thisnameissoclever/parametric-multibin/shells/multibin-shell/MultiBin Shell - Parametric.scad

// MultiBin Shell - parametric remake
// Rebuilds MultiBuild's MultiBin shells (Standard Base) from measurements, so
// matching sizes reproduce the published shells. Other sizes follow the same
// rules, with a rule of this generator's own for a width or front-to-back size
// that ends in a half LU. Paste this whole file into MakerWorld's Parametric
// Model Maker.
//
// Print orientation: the base is on the build plate and the opening is on top.
// X = width, Y = front to back on the plate, Z = up. The left and front outer
// faces are at x = -25 and y = -25, so a whole first cell is centred on the
// origin. A drawer made with the same three numbers fits inside with its bottom
// against the front wall: the drawer's height runs along Y and its depth along Z.

/* [Size in LU (1 LU is 50 mm; the same numbers as the drawer that goes inside)] */
// Width in LU (X). A half LU adds a 25 mm cell at the right end, with no central base pocket
width_lu = 2; // [1:0.5:12]
// Drawer height in LU: the shell's front-to-back size on the build plate (Y). A half LU adds a 25 mm cell at the back, with no central base pocket
height_lu = 1; // [0.5:0.5:12]
// Drawer depth in LU, along the shell's height as printed (Z). The shell is 50 mm per LU plus 5 mm tall
depth_lu = 2; // [1:0.5:12]

/* [Walls (front faces the front of the build plate)] */
// Front wall, which the drawer's bottom goes against. Rail channels sit only on whole 50 mm cells, so a side shorter than 1 LU, and the half-LU end of a side, have none
front_wall = "topped"; // [topped, topless, simple]
// Back wall
back_wall = "topped"; // [topped, topless, simple]
// Left wall (every choice builds the same wall on a shell 0.5 LU front to back)
left_wall = "topped"; // [topped, topless, simple]
// Right wall (every choice builds the same wall on a shell 0.5 LU front to back)
right_wall = "topped"; // [topped, topless, simple]

/* [Hidden] */
// any other wall kind would build a wall that matches no original
for (w = [["front_wall", front_wall], ["back_wall", back_wall], ["left_wall", left_wall], ["right_wall", right_wall]])
    assert(w[1] == "topped" || w[1] == "topless" || w[1] == "simple",
           str(w[0], " must be topped, topless or simple, not ", w[1]));

$fs = 0.25;
$fa = 2;
eps = 0.01;
// thickness of the end slabs of a loft. A solid that continues a loft overlaps
// it by exactly one slab, so the overlapping sections are identical: a larger
// overlap leaves a 0.01 mm ledge where the loft is still narrower, which
// OpenSCAD's export can close into a void at some positions.
slab = 0.001;
arc_fn = 32;                     // facets on the small pocket arcs (chord error 0.011 mm)

U  = 50;
// Shells are built from 25 mm and 50 mm cells, and the drawer generator builds
// a drawer at whatever size it is given, so the shell accepts only the sizes
// its sliders offer: half-LU steps within each range. Any other value stops the
// render with an error, rather than building a shell of a different size from
// the drawer made with the same numbers.
max_lu = 12;
function on_slider(v, lo) = is_num(v) && v >= lo - 1e-6 && v <= max_lu + 1e-6
                            && abs(2 * v - round(2 * v)) < 1e-6;
for (v = [["width_lu", width_lu, 1], ["height_lu", height_lu, 0.5], ["depth_lu", depth_lu, 1]])
    assert(on_slider(v[1], v[2]),
           str(v[0], " must be a multiple of 0.5 from ", v[2], " to ", max_lu, ", not ", v[1]));
// (a value the assert above rejects never reaches the geometry)
function half_lu(v, lo) = on_slider(v, lo) ? round(2 * v) / 2 : lo;
NX = half_lu(width_lu, 1);
NY = half_lu(height_lu, 0.5);
NZ = half_lu(depth_lu, 1);

X0 = -U/2;  X1 = U*NX - U/2;     // outer faces
Y0 = -U/2;  Y1 = U*NY - U/2;
ZT = U*NZ + 5;                   // rim height

wall    = 3.0;                   // outer face to inner face, where no channel or recess is cut
c_out   = 8.737;                 // outer vertical corner chamfer leg
c_in    = 5.565;                 // inner vertical corner chamfer leg
floor_z = 6.0;                   // top of the floor
foot_z  = 6.8;                   // outer face meets the 45-degree foot chamfer
pad_in  = 3.2;                   // base pad inset from the cell edge
pad_top = 3.6;                   // pad's vertical side ends here
bridge_z = 5.4;                  // underside of the floor between pads, beside their flat sides
bridge_lo = 5.2;                 // ... and beside their corner chamfers
foot_c  = 5.8;                   // corner faces meet their outer plane here
corner_in = 2.2;                 // pad corner face inset from the outer corner face
// pad corner chamfer leg, 5.448: set so the pad's corner faces lie exactly on
// the foot's corner planes (a measured 5.448 left them 0.0002 apart)
pad_c   = 2 * (U/2 - pad_in) - (U - c_out) + sqrt(2) * corner_in;

// channel (dovetail rail slot), in face coordinates: t along the face,
// n into the wall from the outer face
ch_open  = 7.0;                  // half width at the face
ch_lip   = 0.4;                  // straight lip before the dovetail flank
ch_half  = 8.5;                  // half width inside, and at the bulges
ch_floor = 2.2;                  // depth of the channel floor
ch_flank = 1.9;                  // flank ends at this depth
// bulge half length at the face: a bulge is a regular octagon 2 * ch_half
// across its flats, cut off where it meets the channel's half width ch_open
bulge_h  = ch_half * tan(22.5) + (ch_half - ch_open);
notch_d  = 0.8;                  // bulge end notches: depth past the bulge side,
notch_n  = 1.0;                  // starting this far below the face,
notch_l  = 2.2;                  // and this long, with 45-degree ends
open_cut = 0.9;                  // open (topless) channel: wall behind it cut this far below the rim
cap_low  = 5.5;                  // cap underside, below the rim, at the face
cap_high = 4.0;                  // cap underside, below the rim, at the flank
roof_c   = 12.5;                 // closed end: the slot turns 45 degrees on each
                                 // side, its centre lines meeting this far below the rim

// inner wall recesses: 0.4 deep, 2.2 tall, rising 1:2 below and 45 degrees above
rec_d    = 0.4;
rec_h    = 2.2;
rec_lo   = 0.8;                  // height of the 1:2 lower slope
catch_t0 = 10.435;               // catch slots span this .. catch_t1 from the LU centre
catch_t1 = 16.435;
catch_z0 = 13.3;                 // lower catch slots: one row, in the first 50 mm band of height
catch_up = 9.2;                  // upper catch slots: this far below the top of each 50 mm band of height
groove_up = 4.2;                 // rim groove: this far below the rim
seam_g   = 0.5;                  // seam groove half width at its floor
seam_flare = 0.002;              // seam slots' inner flare starts this far past the
                                 // groove floor (see seam_slot)

// screw thread in the base holes (right-handed). Along the helix coordinate
// u = z - pitch * angle / 360 (mod pitch), with the angle measured about the
// hole axis from +x: the radius rises 3.0 -> 3.5 over [thr_u[0], thr_u[1]],
// stays 3.5 to thr_u[2], falls back to 3.0 by thr_u[3], and is 3.0 otherwise.
thr_p     = 3.125;
thr_r0    = 3.0;
thr_r1    = 3.5;
thr_u     = [1.0735, 2.0110, 2.6360, 3.5735];
thr_steps = 32;                  // facets per turn (chord error under 0.02 mm)
hole_top  = 5.2;
hole_cone = 3.8;                 // entry cone radius at z = 0 (45 degrees)

// Cells along each axis as [centre, width]: whole 50 mm cells from the origin,
// then one 25 mm cell when the size ends in a half LU. MultiBuild publishes no
// shell whose width or front-to-back size ends in a half LU, so the half cell
// is this generator's own rule: a narrower pad (see half_pad), no rail channel
// on its stretch of wall, which is too short for one, and a catch slot at the
// corner where it ends (see inner_recesses).
nxf = floor(NX + eps);
nyf = floor(NY + eps);
cols = concat([for (i = [0:1:nxf - 1]) [U * i, U]], NX - nxf > eps ? [[U * nxf - U/4, U/2]] : []);
rows = concat([for (j = [0:1:nyf - 1]) [U * j, U]], NY - nyf > eps ? [[U * nyf - U/4, U/2]] : []);
nx_cells = len(cols);
ny_cells = len(rows);
// a side shorter than 1 LU has no whole cell, so no rail channel: every wall
// kind builds the same wall there
if (nyf == 0)
    for (w = [["left_wall", left_wall], ["right_wall", right_wall]]) if (w[1] != "simple")
        echo(str("NOTE: ", w[0], " = ", w[1], " has no effect: the side is shorter than 1 LU, so it has no rail channel."));
// positions of the seams between neighbouring cells along each axis
function seams(cells) = [for (k = [0:1:len(cells) - 2]) cells[k][0] + cells[k][1] / 2];
// half length of the flat part of a pad side, for a cell of width w
function pad_flat(w) = w / 2 - pad_in - pad_c;

// ------------------------------------------------------------------ helpers

// octagon: rectangle [x0,x1]x[y0,y1] with all four corners chamfered by c
function octagon(x0, x1, y0, y1, c) =
    [[x0 + c, y0], [x1 - c, y0], [x1, y0 + c], [x1, y1 - c],
     [x1 - c, y1], [x0 + c, y1], [x0, y1 - c], [x0, y0 + c]];

module oct_prism(x0, x1, y0, y1, c, z0, z1)
    translate([0, 0, z0]) linear_extrude(height = z1 - z0)
        polygon(octagon(x0, x1, y0, y1, c));

// the same octagon offset inward by d (negative d grows it)
function oct_in(x0, x1, y0, y1, c, d) =
    octagon(x0 + d, x1 - d, y0 + d, y1 - d, c - d * (2 - sqrt(2)));

// loft between two convex polygons at z0 and z1, ending in slabs of
// thickness slab
module oct_loft(a, b, z0, z1)
    hull() {
        translate([0, 0, z0]) linear_extrude(height = slab) polygon(a);
        translate([0, 0, z1 - slab]) linear_extrude(height = slab) polygon(b);
    }

// ------------------------------------------------------------------ body

module outer_body() {
    // walls above the foot; the four flat faces get a 1 mm chamfer at the rim,
    // the diagonal corner faces run straight to the top
    intersection() {
        oct_prism(X0, X1, Y0, Y1, c_out, foot_z, ZT);
        translate([0, Y0 - 1, 0]) rotate([-90, 0, 0]) linear_extrude(height = Y1 - Y0 + 2)
            polygon([[X0, -foot_z + 1], [X1, -foot_z + 1], [X1, -(ZT - 1)],
                     [X1 - 1, -ZT], [X0 + 1, -ZT], [X0, -(ZT - 1)]]);
        translate([X0 - 1, 0, 0]) rotate([90, 0, 90]) linear_extrude(height = X1 - X0 + 2)
            polygon([[Y0, foot_z - 1], [Y1, foot_z - 1], [Y1, ZT - 1],
                     [Y1 - 1, ZT], [Y0 + 1, ZT], [Y0, ZT - 1]]);
    }
}

// the outer envelope of everything below the walls: vertical sides inset by
// pad_in, then a 45-degree chamfer out to the outer faces at foot_z
module base_envelope() foot_block(X0, X1, Y0, Y1);

// a block with the foot's chamfers: flat faces inset pad_in below and chamfered
// 45 degrees out to the full face at foot_z, corner faces inset corner_in and
// chamfered 45 degrees out to the full corner at foot_c
module foot_block(x0, x1, y0, y1)
    intersection_for (f = [[0, x1, pad_in, foot_z], [90, y1, pad_in, foot_z],
                           [180, -x0, pad_in, foot_z], [270, -y0, pad_in, foot_z],
                           [45, (x1 + y1 - c_out) / sqrt(2), corner_in, foot_c],
                           [135, (-x0 + y1 - c_out) / sqrt(2), corner_in, foot_c],
                           [225, (-x0 - y0 - c_out) / sqrt(2), corner_in, foot_c],
                           [315, (x1 - y0 - c_out) / sqrt(2), corner_in, foot_c]])
        foot_halfspace(f[0], f[1], f[2], f[3]);

// everything on the inner side of a face whose outward normal points at angle
// ang: the face sits d0 from the origin, inset by `inset` below z_full - inset
// and chamfered 45 degrees up to the full face at z_full
module foot_halfspace(ang, d0, inset, z_full)
    rotate([0, 0, ang]) rotate([90, 0, 0]) linear_extrude(height = 4000, center = true)
        polygon([[-2000, -2], [d0 - inset, -2], [d0 - inset, z_full - inset],
                 [d0, z_full], [d0, foot_z + 1], [-2000, foot_z + 1]]);

module cell_pad(cx, cy, wx = U, wy = U) {
    hx = wx / 2 - pad_in;        // 21.8 for a whole cell
    hy = wy / 2 - pad_in;
    intersection() {
        foot_block(cx - wx / 2, cx + wx / 2, cy - wy / 2, cy + wy / 2);
        union() {
            // 0.4 mm chamfer on the bottom edge
            oct_loft(oct_in(cx - hx, cx + hx, cy - hy, cy + hy, pad_c, 0.4),
                     octagon(cx - hx, cx + hx, cy - hy, cy + hy, pad_c), 0, 0.4);
            translate([cx - U, cy - U, 0.4 - slab]) cube([2 * U, 2 * U, foot_z]);
        }
    }
}

// the floor between the pads, from its underside up to the floor top
module floor_slab()
    difference() {
        intersection() {
            base_envelope();
            union() {
                translate([X0, Y0, bridge_z]) cube([X1 - X0, Y1 - Y0, floor_z - bridge_z]);
                // between the pads the floor reaches down to bridge_lo, except in the
                // gap between two pads' 45-degree faces, where it stops at bridge_z:
                // beside the flat part of each pad side across columns, and along the
                // whole length of the seams between rows (through the crossings)
                difference() {
                    translate([X0, Y0, bridge_lo]) cube([X1 - X0, Y1 - Y0, bridge_z - bridge_lo + eps]);
                    for (sx = seams(cols), r = rows)
                        translate([sx, r[0], 0]) rotate([0, 0, 90]) seam_gap(2 * pad_flat(r[1]));
                    x0 = cols[0][0] - pad_flat(cols[0][1]);
                    x1 = cols[nx_cells - 1][0] + pad_flat(cols[nx_cells - 1][1]);
                    for (sy = seams(rows))
                        translate([(x0 + x1) / 2, sy, 0]) seam_gap(x1 - x0);
                }
            }
        }
        channels_low();
    }

module channels_low()
    for (f = [["front", front_wall, nxf], ["back", back_wall, nxf],
              ["left", left_wall, nyf], ["right", right_wall, nyf]])
        if (f[1] != "simple")
            for (k = [0:1:f[2] - 1])
                place_on_face(f[0], U * k) channel_low();

// the gap between two pads' 45-degree faces near the floor underside, centred on
// a seam running along x, for the given length; its half width at height z is
// pad_in + pad_top - z (1.6 at bridge_lo, 1.4 at bridge_z)
function gap_hw(z) = pad_in + pad_top - z;
module seam_gap(len)
    translate([-len / 2, 0, 0]) rotate([90, 0, 90]) linear_extrude(height = len)
        polygon([[-gap_hw(bridge_lo - 0.1), bridge_lo - 0.1], [gap_hw(bridge_lo - 0.1), bridge_lo - 0.1],
                 [gap_hw(bridge_z + 0.1), bridge_z + 0.1], [-gap_hw(bridge_z + 0.1), bridge_z + 0.1]]);

module cavity() {
    xi0 = X0 + wall; xi1 = X1 - wall; yi0 = Y0 + wall; yi1 = Y1 - wall;
    // 1 mm 45-degree chamfer where the floor meets the walls
    oct_loft(oct_in(xi0, xi1, yi0, yi1, c_in, 1),
             octagon(xi0, xi1, yi0, yi1, c_in), floor_z, floor_z + 1);
    oct_prism(xi0, xi1, yi0, yi1, c_in, floor_z + 1 - slab, ZT - 1.2 + slab);
    // inner rim chamfer: 1.6 out over the top 1.2
    oct_loft(octagon(xi0, xi1, yi0, yi1, c_in),
             oct_in(xi0, xi1, yi0, yi1, c_in, -1.6), ZT - 1.2, ZT);
    translate([0, 0, ZT - slab]) linear_extrude(height = 1 + slab)
        polygon(oct_in(xi0, xi1, yi0, yi1, c_in, -1.6));
}

// ------------------------------------------------------------------ channels

// dovetail channel cutter for one LU of one face, built in face coordinates
// (t across, n into the wall, z up) and placed by the caller
module channel_cutter(kind) {
    if (kind == "topped")
        // each limit must be its own child of intersection(); grouped under one
        // if() they would be unioned first
        intersection() {
            channel_open();
            channel_cap();
            roof_side() channel_roof();
            mirror([1, 0, 0]) roof_side() channel_roof();
        }
    else {
        channel_open();
        // an open rail top also cuts the thin wall behind the channel flat, just
        // below the rim, back to the inner rim chamfer
        translate([-ch_half, -1, ZT - open_cut]) cube([2 * ch_half, wall + 2, open_cut + 1]);
    }
}

// the slot without a closed end: dovetail plus the bulges every 25 mm
module channel_open() {
    profile = [[-ch_open, -1], [ch_open, -1], [ch_open, ch_lip],
               [ch_half, ch_flank], [ch_half, ch_floor],
               [-ch_half, ch_floor], [-ch_half, ch_flank], [-ch_open, ch_lip]];
    translate([0, 0, -1]) linear_extrude(height = ZT + 2) polygon(profile);
    for (k = [0:1:floor(ZT / 25)]) {
        zc = 5 + 25 * k;
        translate([0, ch_floor, 0]) rotate([90, 0, 0])
            linear_extrude(height = ch_floor + 1)
                polygon([[-ch_open, zc - bulge_h], [ch_open, zc - bulge_h],
                         [ch_half, zc - bulge_h + (ch_half - ch_open)],
                         [ch_half, zc + bulge_h - (ch_half - ch_open)],
                         [ch_open, zc + bulge_h], [-ch_open, zc + bulge_h],
                         [-ch_half, zc + bulge_h - (ch_half - ch_open)],
                         [-ch_half, zc - bulge_h + (ch_half - ch_open)]]);
        // a small notch in each side wall at both ends of the bulge
        zs = zc - bulge_h + (ch_half - ch_open);       // bulge straight section starts
        ze = zc + bulge_h - (ch_half - ch_open);       // and ends
        for (m = [0, 1]) mirror([m, 0, 0]) {
            bulge_notch(zs);
            bulge_notch(ze - notch_l);
        }
    }
}

// one notch at the +t side of a bulge, spanning z0 .. z0 + notch_l
module bulge_notch(z0)
    intersection() {
        translate([0, 0, z0 - 1]) linear_extrude(height = notch_l + 2)
            polygon([[ch_half - 0.1, notch_n - 0.1], [ch_half, notch_n],
                     [ch_half + notch_d, notch_n + notch_d],
                     [ch_half + notch_d, ch_floor], [ch_half - 0.1, ch_floor]]);
        translate([0, ch_floor + 0.5, 0]) rotate([90, 0, 0]) linear_extrude(height = 3)
            polygon([[ch_half - 0.1, z0 - 0.1], [ch_half, z0],
                     [ch_half + notch_d, z0 + notch_d], [ch_half + notch_d, z0 + notch_l - notch_d],
                     [ch_half, z0 + notch_l], [ch_half - 0.1, z0 + notch_l + 0.1]]);
    }

// below the cap: its underside is hooked 45 degrees between the lip and the flank
module channel_cap()
    translate([-20, 0, 0]) rotate([90, 0, 90]) linear_extrude(height = 40)
        polygon([[-1, -2], [-1, ZT - cap_low], [ch_lip, ZT - cap_low],
                 [ch_flank, ZT - cap_high], [ch_floor + 1, ZT - cap_high],
                 [ch_floor + 1, -2]]);

// one side of the closed end, built as a dovetail half-profile in (s, n)
// extruded along the 45-degree line and rotated into place
// (sized from the shell height: a fixed size would clip the bottom of tall shells)
module channel_roof()
    linear_extrude(height = 8 * ZT, center = true)
        polygon([[-4 * ZT, -1], [ch_open, -1], [ch_open, ch_lip], [ch_half, ch_flank],
                 [ch_half, ch_floor + 1], [-4 * ZT, ch_floor + 1]]);

module roof_side()
    translate([(ZT - roof_c) / 2, 0, (ZT - roof_c) / 2]) rotate([0, -45, 0]) children();

// place a cutter on a face: side is "front", "back", "left" or "right"
module place_on_face(side, s) {
    if (side == "front")      translate([s, Y0, 0]) children();
    else if (side == "back")  translate([s, Y1, 0]) rotate([0, 0, 180]) children();
    else if (side == "left")  translate([X0, s, 0]) rotate([0, 0, -90]) children();
    else if (side == "right") translate([X1, s, 0]) rotate([0, 0, 90]) children();
}

module channels() {
    for (f = [["front", front_wall, nxf], ["back", back_wall, nxf],
              ["left", left_wall, nyf], ["right", right_wall, nyf]])
        if (f[1] != "simple")
            for (k = [0:1:f[2] - 1])
                place_on_face(f[0], U * k) channel_cutter(f[1]);
}

// ------------------------------------------------------------------ inner recesses

// z profile shared by the catch slots and the rim groove, as a polygon in (n, z)
// where n is depth into the wall from the inner face
function rec_profile(z0) =
    [[-1, z0 - 0.5], [0, z0], [rec_d, z0 + rec_lo], [rec_d, z0 + rec_h - rec_d],
     [0, z0 + rec_h], [-1, z0 + rec_h + 1]];

// a recess on the inner face of a wall between t0 and t1, in face coordinates
// (t along, n into the wall from the inner face, z up); its ends are 45 degrees
// in t, which at the corners is exactly the inner corner chamfer plane
module wall_recess(z0, t0, t1)
    intersection() {
        translate([0, 0, z0 - 1]) linear_extrude(height = rec_h + 2)
            polygon([[t0 - 1, -1], [t1 + 1, -1], [t1, 0], [t1 - rec_d, rec_d], [t0 + rec_d, rec_d], [t0, 0]]);
        rotate([90, 0, 90]) translate([0, 0, t0 - 2])
            linear_extrude(height = t1 - t0 + 4) polygon(rec_profile(z0));
    }

module catch_slot(z0) wall_recess(z0, catch_t0, catch_t1);

// a vertical groove on the inner face at a seam, z0 .. z1
module seam_groove(z0, z1)
    intersection() {
        translate([0, 0, z0 - 1]) linear_extrude(height = z1 - z0 + 2)
            polygon([[-seam_g - rec_d - 1, -1], [seam_g + rec_d + 1, -1], [seam_g + rec_d, 0],
                     [seam_g, rec_d], [-seam_g, rec_d], [-seam_g - rec_d, 0]]);
        rotate([90, 0, 90]) translate([0, 0, -5]) linear_extrude(height = 10)
            polygon([[-1, z0 - 0.5], [0, z0], [rec_d, z0 + rec_lo], [rec_d, z1 - rec_d],
                     [0, z1], [-1, z1 + 1]]);
    }

// place a feature on the inner face of a wall: the outer face frame shifted by
// the wall thickness, so n is measured from the inner face
module place_inner(side, s)
    place_on_face(side, s) translate([0, wall, 0]) mirror([0, 1, 0]) children();

module inner_recesses() {
    // upper catch slots sit below each 50 mm band top and below the rim; the
    // two coincide when the depth is a whole number of LU
    zbands = concat([for (k = [1:1:floor(NZ + eps)]) 5 + U * k],
                    abs(NZ - floor(NZ + eps)) > eps ? [ZT] : []);
    for (f = [["front", nxf, front_wall, cols, (X0 + X1) / 2, X1 - X0],
              ["back", nxf, back_wall, cols, (X0 + X1) / 2, X1 - X0],
              ["left", nyf, left_wall, rows, (Y0 + Y1) / 2, Y1 - Y0],
              ["right", nyf, right_wall, rows, (Y0 + Y1) / 2, Y1 - Y0]]) {
        for (k = [0:1:f[1] - 1]) place_inner(f[0], U * k) for (m = [0, 1]) mirror([m, 0, 0]) {
            catch_slot(catch_z0);
            for (zb = zbands) catch_slot(zb - catch_up);
        }
        // The outermost catch slot of a whole cell ends where the flat inner face
        // ends, so every inner corner of a published shell has one. A half cell
        // has no centre to place slots from, so the corner at its end gets a slot
        // of the same length ending at the same place. A side shorter than 1 LU
        // is a half cell alone: its two corner slots would overlap, so they are
        // one recess along the whole flat face. Each is placed at its own
        // midpoint because the back and left face frames run backwards.
        fl = f[5] / 2 - wall - c_in;                    // half length of the flat inner face
        cl = catch_t1 - catch_t0;
        corner = f[1] == 0 ? [f[4] - fl, f[4] + fl]
               : len(f[3]) > f[1] ? [f[4] + fl - cl, f[4] + fl] : [];
        if (len(corner) == 2) place_inner(f[0], (corner[0] + corner[1]) / 2)
            for (z = concat([catch_z0], [for (zb = zbands) zb - catch_up]))
                wall_recess(z, -(corner[1] - corner[0]) / 2, (corner[1] - corner[0]) / 2);
        // seam grooves between LUs along the face, one per 50 mm band (a partial
        // top band included), each ending 7 mm below the top of its band. On a
        // simple wall the groove in a partial top band is short, starting at the
        // upper catch slot height (measured on the 1x2x1.5 Simple Walls shell).
        for (sk = seams(f[3])) place_inner(f[0], sk)
            for (b = [0:1:ceil(NZ - eps) - 1])
                seam_groove(f[2] == "simple" && U * (b + 1) + 5 > ZT + eps ? ZT - catch_up : catch_z0 + U * b,
                            min(U * (b + 1) + 5, ZT) - 7);
        // a groove along the whole flat inner face at the rim, except that an open
        // (topless) rail wall leaves it out behind each rail channel. rim lists
        // the groove's segments as start, end pairs along the face; each segment
        // is placed at its own midpoint, as the corner catch slots are.
        rim = f[2] == "topless"
            ? concat([f[4] - fl], [for (k = [0:1:f[1] - 1]) each [U * k - catch_t0, U * k + catch_t0]], [f[4] + fl])
            : [f[4] - fl, f[4] + fl];
        for (i = [0:2:len(rim) - 2]) place_inner(f[0], (rim[i] + rim[i + 1]) / 2)
            wall_recess(ZT - groove_up, -(rim[i + 1] - rim[i]) / 2, (rim[i + 1] - rim[i]) / 2);
    }
}

// ------------------------------------------------------------------ clip slots

// octagonal section in the (t, z) plane at depth n: half width a, half height b,
// corner chamfer c
module oct_slab(a, b, c, n)
    translate([0, n, 0]) rotate([-90, 0, 0]) linear_extrude(height = slab)
        polygon([[-a + c, -b], [a - c, -b], [a, -b + c], [a, b - c],
                 [a - c, b], [-a + c, b], [-a, b - c], [-a, -b + c]]);

// the 0.2 mm 45-degree chamfer around a slot's outer opening, started 0.1
// outside the face so the cut overlaps it: the 6 x 2 opening grown by 0.3
module slot_mouth()
    hull() { oct_slab(3.3, 1.3, 0.4 + 0.3 * (2 - sqrt(2)), -0.1); oct_slab(3.0, 1.0, 0.4, 0.2); }

// waisted through-slot at a seam: 6 x 2 at both faces, 4 wide in the middle.
// Face frame: t across, n from the outer face inward, z up; centred on z = zc
//
// The inner flare starts 0.002 past n = 2.6, the floor of the inner grooves
// (wall - rec_d), and keeps its end section, so its opening at the inner face
// stays within 0.001 of the original's and its slope steepens slightly. The
// grooves are placed from the inner face and the slot from the outer face, so
// a flare starting in the groove floor's plane meets it a rounding error away,
// leaving zero-width fins whose vertex pairs a merge on import folds into
// edges with four faces.
module seam_slot(zc)
    translate([0, 0, zc]) {
        slot_mouth();
        hull() { oct_slab(3.0, 1.0, 0.4, 0.2);   oct_slab(3.0, 1.0, 0.4, 0.8); }
        hull() { oct_slab(2.2, 1.0, 0.318, 0.8); oct_slab(2.0, 1.0, 0.4, 1.0); }
        hull() { oct_slab(2.0, 1.0, 0.4, 1.0);   oct_slab(2.0, 1.0, 0.4, 1.8); }
        hull() { oct_slab(2.0, 1.0, 0.4, 1.8);   oct_slab(2.2, 1.0, 0.318, 2.0); }
        hull() { oct_slab(3.0, 1.0, 0.4, 2.0);   oct_slab(3.0, 1.0, 0.4, 2.6 + seam_flare); }
        hull() { oct_slab(3.0, 1.0, 0.4, 2.6 + seam_flare); oct_slab(3.5, 1.5, 0.693, 3.1); }
    }

// the slot through each outer corner, at the same height as the top seam slots;
// the corner wall is 2 mm thick, so only the outer part of the seam slot profile
// exists there
module corner_slot(zc)
    translate([0, 0, zc]) {
        slot_mouth();
        hull() { oct_slab(3.0, 1.0, 0.4, 0.2);   oct_slab(3.0, 1.0, 0.4, 0.8); }
        hull() { oct_slab(2.2, 1.0, 0.318, 0.8); oct_slab(2.0, 1.0, 0.4, 1.0); }
        hull() { oct_slab(2.0, 1.0, 0.4, 1.0);   oct_slab(2.0, 1.0, 0.4, 1.8); }
        hull() { oct_slab(2.0, 1.0, 0.4, 1.8);   oct_slab(2.5, 1.5, 0.693, 2.3); }
    }

module corner_slots()
    for (c = [[X1, Y1, 45], [X0, Y1, 135], [X0, Y0, 225], [X1, Y0, 315]]) {
        // centre of the diagonal corner face
        fx = c[0] - sign(c[0] - (X0 + X1) / 2) * c_out / 2;
        fy = c[1] - sign(c[1] - (Y0 + Y1) / 2) * c_out / 2;
        translate([fx, fy, 0]) rotate([0, 0, c[2] + 90]) corner_slot(ZT - 3);
    }

module seam_slots() {
    for (f = [["front", cols], ["back", cols], ["left", rows], ["right", rows]])
        for (sk = seams(f[1])) place_on_face(f[0], sk)
            for (zc = [27:25:ZT - 1]) seam_slot(zc);
}

// ------------------------------------------------------------------ base pockets

// octagonal bar used by the pad clip pockets: half width a, z 1 .. 3, 0.4
// chamfers on the long edges, running along y from y0 to y1
module pocket_bar(a, y0, y1)
    translate([0, y1, 2]) rotate([90, 0, 0]) linear_extrude(height = y1 - y0)
        polygon(pocket_section(a, 1, 0.4));

// octagonal pocket section about z = 2: half width a, half height b, chamfer c
function pocket_section(a, b, c) =
    [[-a + c, -b], [a - c, -b], [a, -b + c], [a, b - c], [a - c, b], [-a + c, b], [-a, b - c], [-a, -b + c]];

// a thin slice of a pocket section at depth y along the pocket axis
module pocket_slab(a, b, c, y)
    translate([0, y, 2]) rotate([90, 0, 0]) linear_extrude(height = slab) polygon(pocket_section(a, b, c));

// clip pocket entering a pad side, built for the +y side of a pad centred at the
// origin, at t along the side: a 6 wide entry, then an obround head
module side_pocket(t) {
    h = U/2 - pad_in;                                   // 21.8, the pad face
    translate([t, 0, 0]) {
        translate([0, 0, 1]) linear_extrude(height = 2) side_pocket_outline(h + 0.5);
        hull() {                                        // 0.2 chamfer at the opening
            translate([-3, h - 0.2, 1]) cube([6, slab, 2]);
            translate([-3.2, h, 1]) cube([6.4, 0.5, 2]);
        }
        // ceiling slits, 0.1 wide and 0.2 tall, following the pocket outline but
        // stopping 0.01 short of it, as the central pocket's slits do
        translate([0, 0, 2.9]) linear_extrude(height = 0.3)
            intersection() {
                offset(delta = -0.01) side_pocket_outline(h);
                for (ys = [16.7, 17.6, 19.7]) translate([-10, ys]) square([20, 0.1]);
            }
    }
}

// plan of a side clip pocket: a 6 wide entry from the pad face to an obround head
module side_pocket_outline(y1) {
    translate([-3, 19.0]) square([6, y1 - 19.0]);
    hull() for (dx = [-1.25, 1.25]) translate([dx, 18.05]) circle(r = 2.25, $fn = arc_fn);
}

// T-shaped clip pocket entering a pad corner along its diagonal, built for the
// +x+y corner of a pad centred at the origin
module corner_pocket() {
    sf = (2 * (U/2 - pad_in) - pad_c) / sqrt(2);        // corner face, along the diagonal
    rotate([0, 0, -45]) {
        pocket_bar(2.0, sf - 2.8, sf + 0.5);
        pocket_bar(3.0, sf - 4.8, sf - 2.8);
        // 0.2 mm 45-degree chamfer around the opening
        hull() { pocket_slab(2.0, 1.0, 0.4, sf - 0.2); pocket_slab(2.5, 1.5, 0.693, sf + 0.3); }
    }
}

// pyramid notch under the middle of a pad side whose face is h from the pad
// centre (built for the +y side): a 45-degree chamfer across the edge,
// y - z >= h - 2.3, and two 45-degree chamfers along the diagonals,
// y -+ x - sqrt(2) z >= h - 4.578
module edge_notch(h = U/2 - pad_in) {
    intersection() {
        translate([-10, 0, 0]) rotate([90, 0, 90]) linear_extrude(height = 20)
            polygon([[h - 2.3 - 1, -1], [h + 1, -1], [h + 1, 3.3], [h - 2.3, 0]]);
        notch_side(1, h - 4.578);
        notch_side(-1, h - 4.578);
    }
}

// half-space y - sg * x - sqrt(2) z >= c inside a box; faces wound clockwise
// seen from outside
module notch_side(sg, c)
    polyhedron(
        points = [[-10, c - sg * 10 - sqrt(2), -1], [10, c + sg * 10 - sqrt(2), -1],
                  [10, c + sg * 10 + 4 * sqrt(2), 4], [-10, c - sg * 10 + 4 * sqrt(2), 4],
                  [-10, c + 25, -1], [10, c + 25, -1], [10, c + 25, 4], [-10, c + 25, 4]],
        faces = [[0, 3, 2, 1], [4, 5, 6, 7], [0, 1, 5, 4], [7, 6, 2, 3], [2, 6, 5, 1], [7, 3, 0, 4]]);

// the central pocket of each pad (built at the origin). The prism's sides would
// meet in a point at (0, 6.021); the references stop it at the octagon's face,
// y = 6.0, so its tip is cut off there.
function point_prism(b) =
    [[-(18.021 + b), b], [18.021 + b, b], [8.5, -9.521], [8.5, -2.479], [0.021, 6.0],
     [-0.021, 6.0], [-8.5, -2.479], [-8.5, -9.521]];
module central_pocket() {
    // flared octagon: half 6.0 at z = 0.4 growing 45 degrees to 8.5 at z = 2.9
    oct_prism(-6.0, 6.0, -6.0, 6.0, 3.515, -1, 0.4 + slab);
    oct_loft(octagon(-6.0, 6.0, -6.0, 6.0, 3.515), octagon(-8.5, 8.5, -8.5, 8.5, 4.979), 0.4, 2.9);
    oct_prism(-8.5, 8.5, -8.5, 8.5, 4.979, 2.9 - slab, 3.2);
    // the prism, its flat end at -y stepping out 45 degrees between z 1.8 and 2.2
    translate([0, 0, -1]) linear_extrude(height = 2.8 + slab) polygon(point_prism(-14.5));
    oct_loft(point_prism(-14.5), point_prism(-14.9), 1.8, 2.2);
    translate([0, 0, 2.2 - slab]) linear_extrude(height = 1.0 + slab) polygon(point_prism(-14.9));
    // ceiling slits over the pointed prism, every 1 mm. They stop 0.01 short of
    // the prism's sides: slit ends flush with those faces made OpenSCAD's export
    // seal some slits into voids at some pad positions.
    translate([0, 0, 3.0]) linear_extrude(height = 0.4)
        intersection() {
            offset(delta = -0.01) polygon(point_prism(-14.9));
            for (k = [0:8]) translate([-10, -14.2 + k]) square([20, 0.1]);
        }
    // a plate up to 3.4 in the middle band, a square to 3.6, then the octagon to 5.2
    // the plate keeps the flared octagon's two top chamfers; its lower corners are square
    translate([0, 0, 3.2 - eps]) linear_extrude(height = 0.2 + eps)
        polygon([[-8.5, -5.1], [8.5, -5.1], [8.5, 3.521], [6.921, 5.1], [-6.921, 5.1], [-8.5, 3.521]]);
    translate([-5.1, -5.1, 3.4 - eps]) cube([10.2, 10.2, 0.2 + eps]);    // ends at 3.6, where the octagon takes over
    oct_prism(-5.1, 5.1, -5.1, 5.1, 2.988, 3.6 - eps, 5.2);
}

// One pad with every feature cut, built at the origin so that identical pads
// share one evaluation. outward lists, for each pad side in the order +y, -x,
// -y, +x, whether it faces the outside of the shell. Side clip pockets only
// open onto the outside; a side facing a neighbouring pad has none.
module pad_variant(outward)
    difference() {
        pad_core();
        for (k = [0:3]) if (outward[k]) rotate([0, 0, 90 * k]) {
            side_pocket(7.5);
            side_pocket(-7.5);
        }
    }

// everything every pad has, whatever its neighbours: evaluated once per render
module pad_core()
    difference() {
        intersection() {
            cell_pad(0, 0);
            translate([-U, -U, -1]) cube([2 * U, 2 * U, floor_z + 1]);
        }
        central_pocket();
        for (k = [0:3]) rotate([0, 0, 90 * k]) {
            corner_pocket();
            edge_notch();
        }
        for (dx = [-12.5, 12.5], dy = [-12.5, 12.5]) translate([dx, dy, 0]) threaded_hole();
    }

// the part of a channel cutter below the floor top, in face coordinates
module channel_low()
    intersection() {
        channel_open();
        translate([-20, -2, -2]) cube([40, wall + 4, floor_z + 2.5]);
    }

// every pad, with the bottom of each rail channel cut down through the pads'
// feet, as through the floor, whether the pad under it is whole or half
module pads()
    difference() {
        for (i = [0:nx_cells - 1], j = [0:ny_cells - 1]) {
            c = cols[i];
            r = rows[j];
            outward = [j == ny_cells - 1, i == 0, j == 0, i == nx_cells - 1];
            if (c[1] == U && r[1] == U)
                translate([c[0], r[0], 0]) pad_variant(outward);
            else
                half_pad(c[0], r[0], c[1], r[1], outward);
        }
        channels_low();
    }

// A pad on a half-LU cell centred at (cx, cy), wx by wy, with outward listing
// which sides face the outside of the shell (order +y, -x, -y, +x, as for
// pad_variant). Its outline is built in place rather than moved there, so its
// corner faces at a shell corner come from the same numbers as the floor's and
// coincide with them exactly. It has the
// threaded holes on the 25 mm grid; a corner clip pocket at each corner, placed
// as at a whole pad's corners; and, on each 50 mm side, the edge notch and,
// facing outward, the side clip pockets. A whole pad's central pocket does not
// fit, nor do a notch or side pockets on a 25 mm side, whose flat part is
// narrower than the notch.
module half_pad(cx, cy, wx, wy, outward)
    difference() {
        intersection() {
            cell_pad(cx, cy, wx, wy);
            translate([cx - U, cy - U, -1]) cube([2 * U, 2 * U, floor_z + 1]);
        }
        translate([cx, cy, 0]) half_pad_cuts(wx, wy, outward);
    }

// the holes, notches and pockets of a half pad centred at the origin
module half_pad_cuts(wx, wy, outward) {
        for (dx = wx == U ? [-12.5, 12.5] : [0], dy = wy == U ? [-12.5, 12.5] : [0])
            translate([dx, dy, 0]) threaded_hole();
        for (k = [0:3]) {
            side_l = k % 2 == 0 ? wx : wy;                  // length of side k
            shift = ((k % 2 == 0 ? wy : wx) - U) / 2;       // its face, from a whole pad's
            if (side_l == U) rotate([0, 0, 90 * k]) translate([0, shift, 0]) {
                edge_notch();
                if (outward[k]) {
                    side_pocket(7.5);
                    side_pocket(-7.5);
                }
            }
        }
        // rotating by 90k takes the +x+y corner to the corner with these signs
        for (k = [0:3]) let (sg = [[1, 1], [-1, 1], [-1, -1], [1, -1]][k])
            translate([sg[0] * (wx - U) / 2, sg[1] * (wy - U) / 2, 0]) rotate([0, 0, 90 * k])
                corner_pocket();
}

// ------------------------------------------------------------------ holes

// one blind threaded hole, axis at the origin, from below z = 0 up to hole_top
module threaded_hole() {
    intersection() {
        union() {
            rotate([0, 0, 180 / thr_steps]) translate([0, 0, -1])
                cylinder(r = thr_r0 / cos(180 / thr_steps), h = hole_top + 1, $fn = thr_steps);
            thread_ridge(-thr_p, 3);
        }
        translate([-5, -5, -1]) cube([10, 10, hole_top + 1]);
    }
    // 45-degree entry cone, faceted like the core cylinder (same turn, faces
    // touching the true surface) and ending exactly at the core's polygon, so
    // the two share that ring of points instead of crossing next to it, which
    // left the 3MF export pairs of separate vertices at one position
    rotate([0, 0, 180 / thr_steps]) translate([0, 0, -1])
        cylinder(r1 = (hole_cone + 1) / cos(180 / thr_steps), r2 = thr_r0 / cos(180 / thr_steps),
                 h = 1 + hole_cone - thr_r0, $fn = thr_steps);
}

// the groove of an internal thread as a helical bar with a trapezoid section,
// starting at z0 and running the given number of turns; its inner edge sits
// just inside the core cylinder so the two overlap
function thr_section() =
    let (k = (thr_u[1] - thr_u[0]) / (thr_r1 - thr_r0), ri = thr_r0 - 0.05)
    [[ri, thr_u[0] - k * 0.05], [thr_r1, thr_u[1]], [thr_r1, thr_u[2]], [ri, thr_u[3] + k * 0.05]];

module thread_ridge(z0, turns) {
    n = thr_steps * turns;
    sec = thr_section();
    pts = [for (i = [0:n]) let (a = 360 * i / thr_steps, dz = z0 + thr_p * i / thr_steps)
               for (q = sec) [q[0] * cos(a), q[0] * sin(a), q[1] + dz]];
    // each side face twists along the helix, so it is split into two triangles
    faces = concat(
        [[3, 2, 1, 0]],
        [[4 * n, 4 * n + 1, 4 * n + 2, 4 * n + 3]],
        [for (i = [0:n - 1], k = [0:3])
            let (a = 4 * i + k, b = 4 * i + (k + 1) % 4) each [[a, b, b + 4], [a, b + 4, a + 4]]]);
    polyhedron(points = pts, faces = faces);
}

// ------------------------------------------------------------------ model

// Everything from the floor top up: walls, rim and floor chamfer. Built apart
// from the base so that the many wall cutters never touch the base geometry.
module walls_part()
    difference() {
        union() {
            outer_body();
            intersection() {
                base_envelope();
                // reaching one slab into the floor, where both have the same section,
                // so the two parts overlap instead of only touching at the floor top
                translate([X0 - 1, Y0 - 1, floor_z - slab]) cube([X1 - X0 + 2, Y1 - Y0 + 2, foot_z - floor_z + slab + eps]);
            }
        }
        cavity();
        channels();
        inner_recesses();
        seam_slots();
        corner_slots();
    }

union() {
    walls_part();
    floor_slab();
    pads();
}
