thisnameissoclever/parametric-multibin/(list of files, cad)

Other CAD files:
drawers/simple-drawer/analysis/fixtures/frozen_round5.scad
shells/multibin-shell/analysis/fixtures/frozen_a6ff94e.scad
