thisnameissoclever/parametric-multibin/(commit log)

2026-10-08 Add the parametric MultiBin simple drawer and its verification tools
    The drawer generator reproduces MultiBuild's MultiBin Simple Drawer inserts
    from parameters, as one self-contained OpenSCAD file that pastes into
    MakerWorld's Parametric Model Maker. It was verified against MultiBuild's
    reference drawers and countersigned by independent reviewers before this
    import; the generator file is unchanged (SHA-256 85487774...).
    Also included:
    - The comparison harness, regression gate with its locked baseline, and the
    measurement scripts that DEVIATIONS.md cites as evidence. Machine-specific
    paths now resolve through tools/mbpaths.py from local-paths.json or
    environment variables, so the scri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
    [MultiBin Simple Drawer - Parametric.scad, frozen_round5.scad, parse_test.scad]
2026-10-12 Add the parametric MultiBin shell generator and its verification gate
    `shells/multibin-shell/MultiBin Shell - Parametric.scad` rebuilds MultiBuild's MultiBin Shell (Standard Base) as one OpenSCAD 2021.01 file for MakerWorld's Parametric Model Maker. It takes a width of 1 to 12 LU, a front-to-back size of 0.5 to 12 LU and a drawer depth of 1 to 12 LU in half-LU steps (1 LU is 50 mm), and a wall kind for each side: Topped Rail, Topless Rail or Simple.
    At MultiBuild's 14 published sizes the output matches the original files within 0.02 mm at every vertex, with equal bounding boxes and volumes within 0.01 %. `DEVIATIONS.md` lists the known differences, the largest being 0.019 mm from faceting,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
2026-11-07 Add uneven compartments, divider thickness and finger scoops to the drawer
    The drawer generator gains uneven compartments (`width_ratios`, `depth_ratios`), a divider thickness from 0.6 to 4 mm, and finger scoops cut into the tops of the dividers (`divider_scoop` front or center, `divider_scoop_mm`). With every new parameter at its default the output matches the generator before this change.
    The ninth reference drawer (3x3x2 LU) is back on the build machine, so the drawer's baseline is relocked with all nine originals and VERIFICATION.md names this generator's digest. The drawer gate passes with nine of nine originals inside every limit and no drift.
    Merged at Tim's request of 2026-11-07, b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
